hbahk/isoplane-back-illumination/preview-v09.png

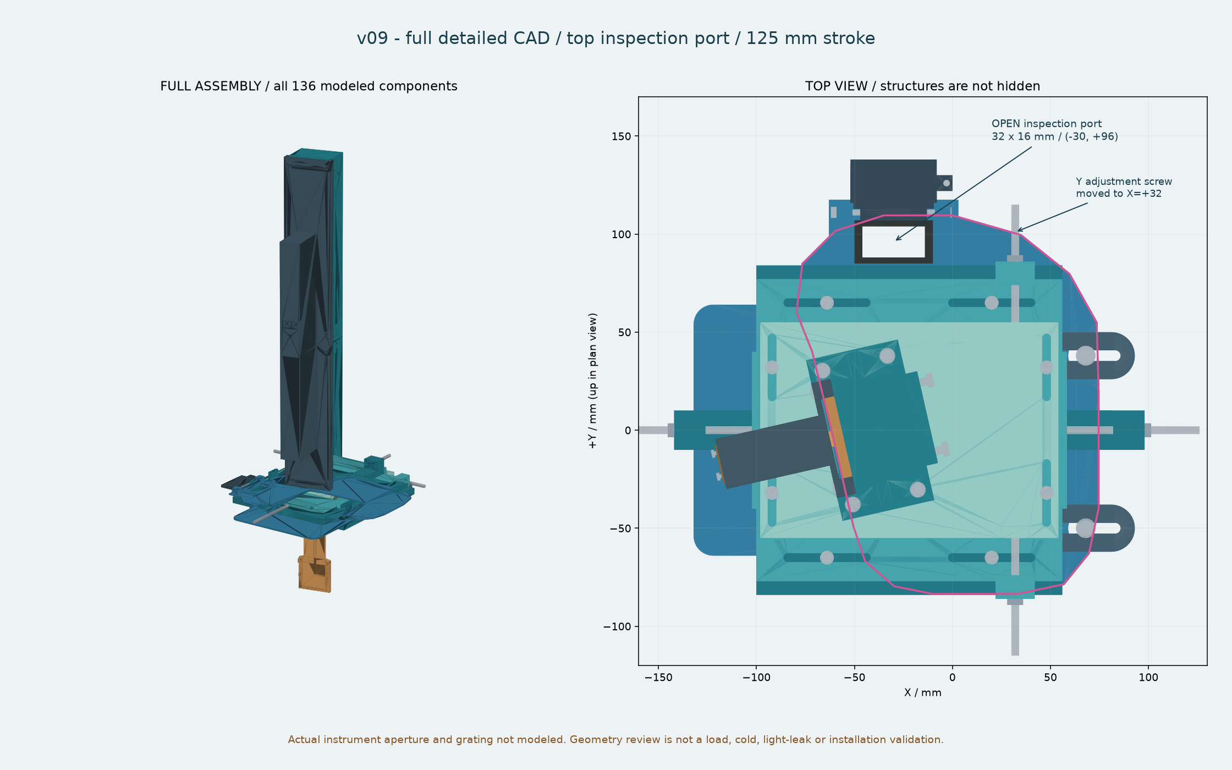
preview-v09.png
