hbahk/isoplane-back-illumination/preview.png

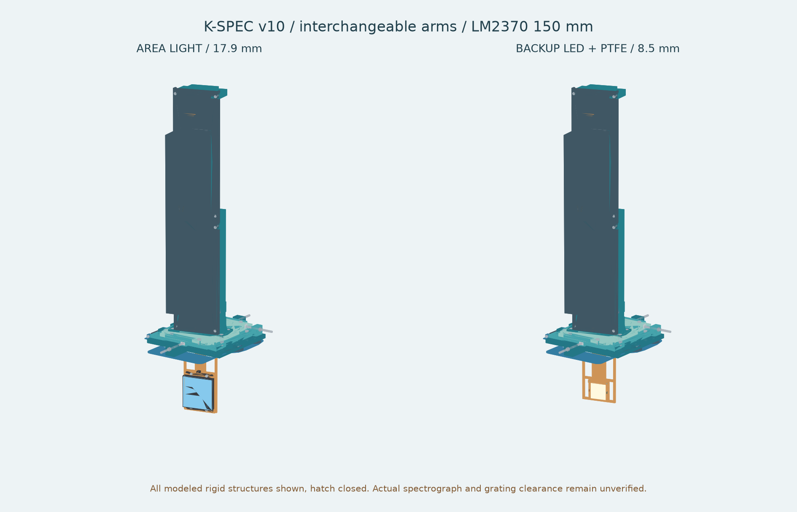
preview.png
