hbahk/isoplane-back-illumination/models/assembly_v17f_OUT.stl

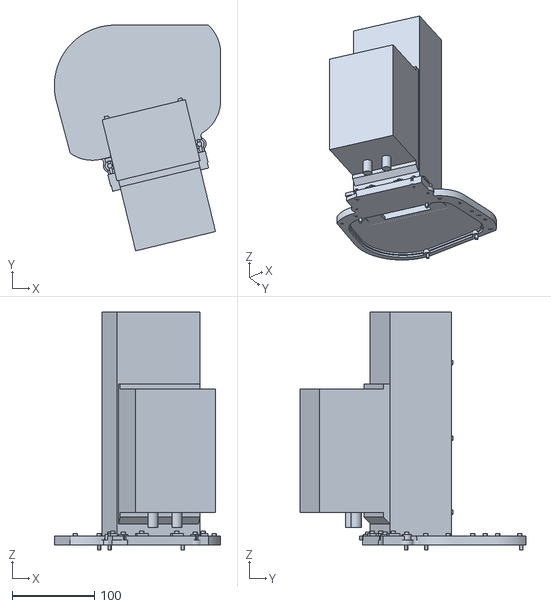
[picture p10: CAD file, 2026-11-11]
models/assembly_v17f_OUT.stl
202.2 x 274.5 x 289.4
