hbahk/isoplane-back-illumination/models/print/V17f_lid.stl

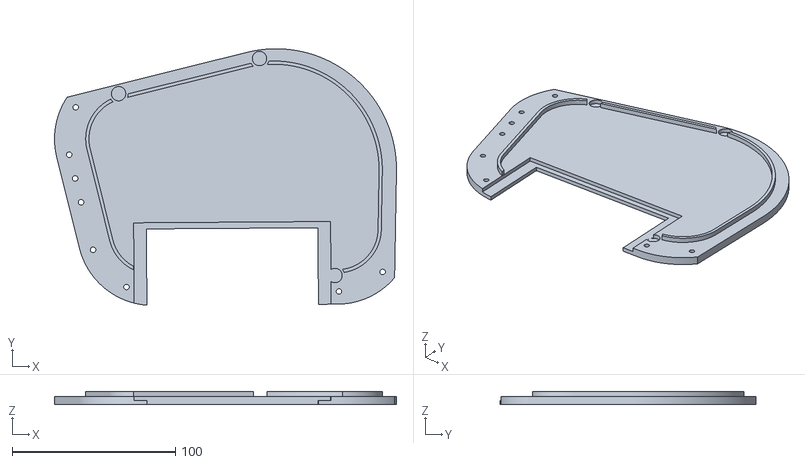
[picture p11: CAD file, 2026-11-11]
models/print/V17f_lid.stl
209.4 x 157.0 x 8.00
