hbahk/isoplane-back-illumination/models/print/V17f_tower_base.stl

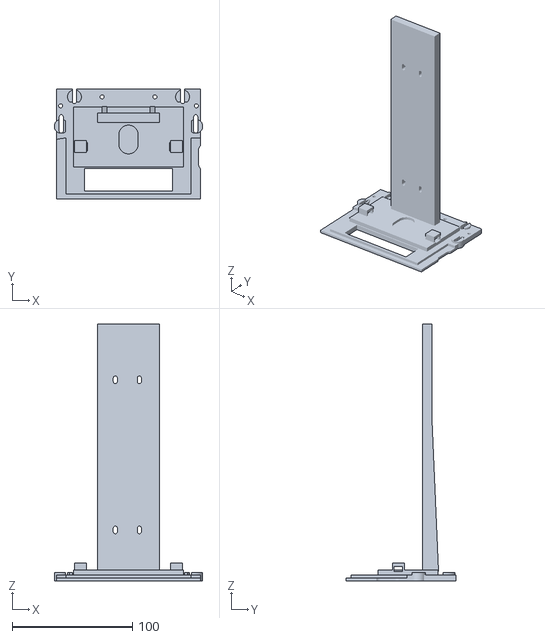
[picture p12: CAD file, 2026-11-11]
models/print/V17f_tower_base.stl
123.6 x 91.5 x 214.0
