hbahk/isoplane-back-illumination/models/print/coupon_B_front_boss.stl

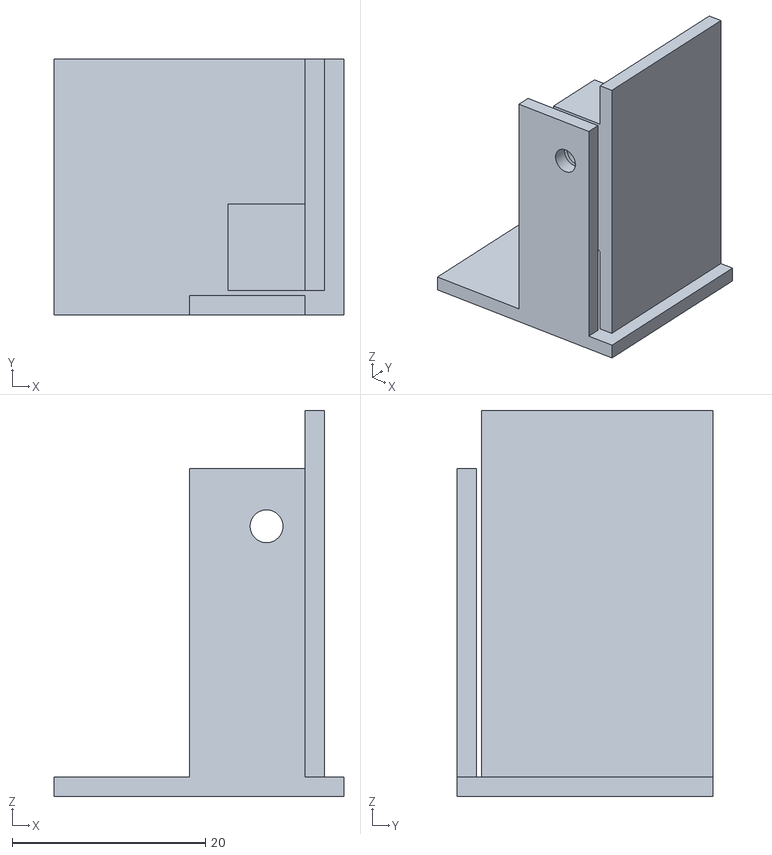
[picture p13: CAD file, 2026-11-11]
models/print/coupon_B_front_boss.stl
30.0 x 26.5 x 40.0
