hbahk/isoplane-back-illumination/models/print/V17f_front_panel.stl

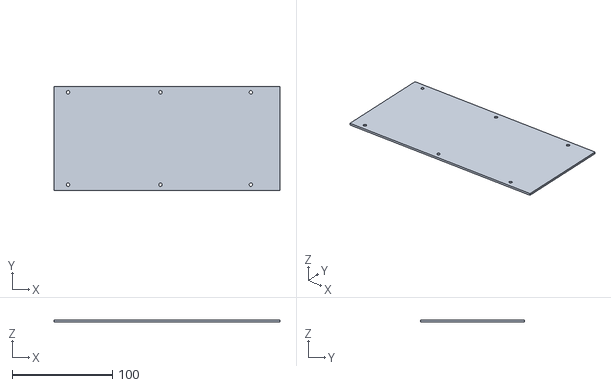
[picture p14: CAD file, 2026-11-11]
models/print/V17f_front_panel.stl
225.0 x 104.0 x 2.00
