hbahk/isoplane-back-illumination/models/print/V17f_ring_base.stl

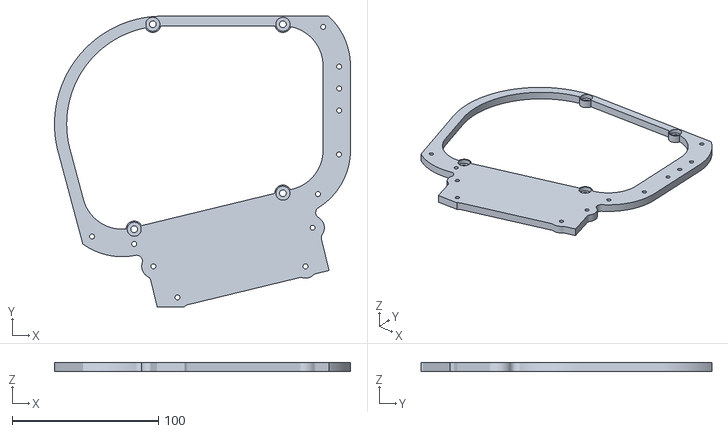
[picture p15: CAD file, 2026-11-11]
models/print/V17f_ring_base.stl
202.2 x 198.7 x 6.00
