hbahk/isoplane-back-illumination/models/print/V17f_enclosure.stl

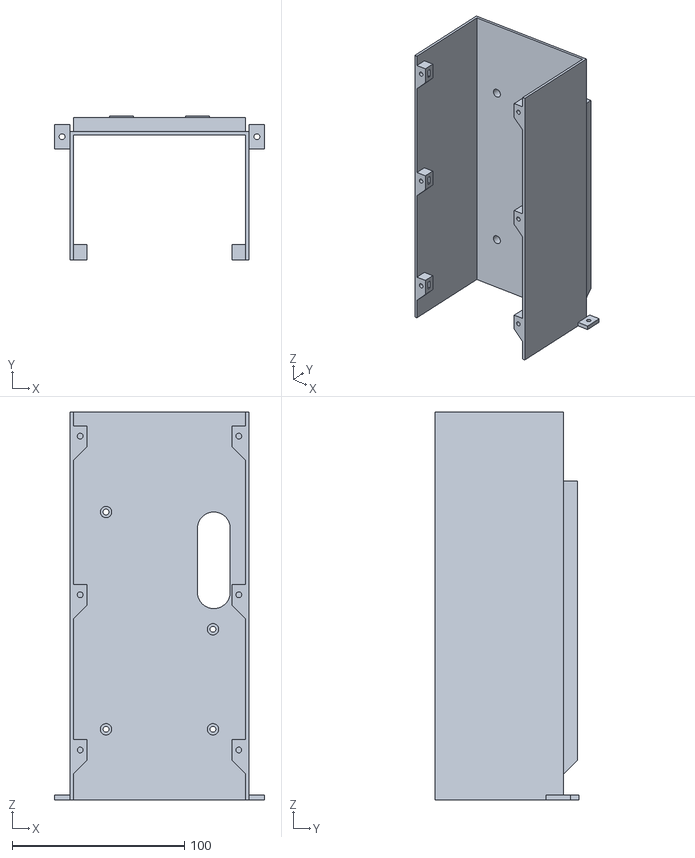
[picture p16: CAD file, 2026-11-11]
models/print/V17f_enclosure.stl
122.0 x 83.5 x 225.0
