hbahk/isoplane-back-illumination/models/print/V17f_backup_strip_module.stl

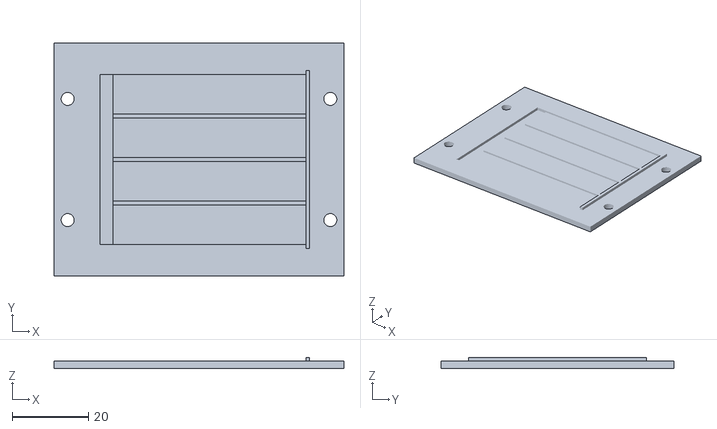
[picture p17: CAD file, 2026-11-11]
models/print/V17f_backup_strip_module.stl
76.0 x 61.0 x 3.00
