hbahk/isoplane-back-illumination/models/print/V17f_backup_led_module.stl

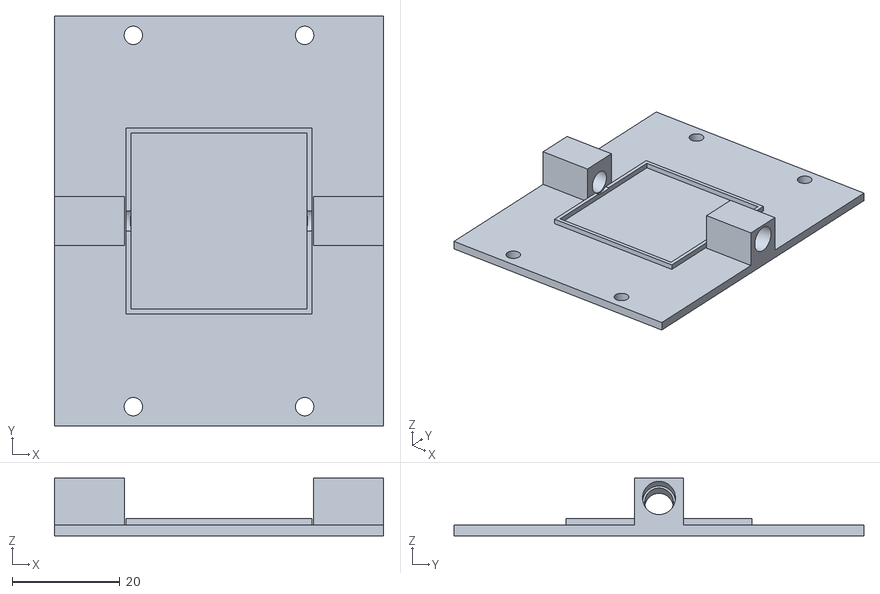
[picture p18: CAD file, 2026-11-11]
models/print/V17f_backup_led_module.stl
61.0 x 76.0 x 10.7
