hbahk/isoplane-back-illumination/models/print/V17f_top_cap.stl

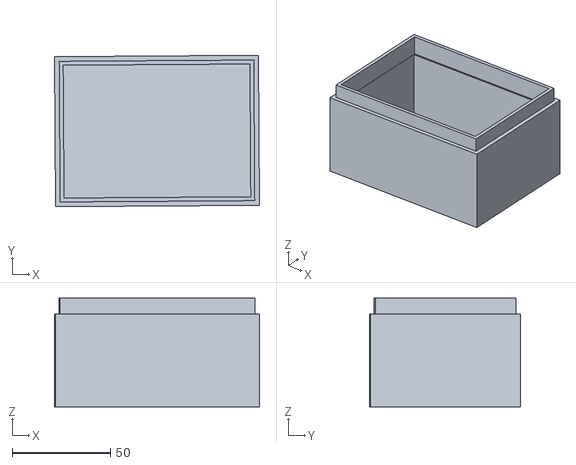
[picture p19: CAD file, 2026-11-11]
models/print/V17f_top_cap.stl
104.5 x 77.2 x 55.5
