hbahk/isoplane-back-illumination/models/print/V17f_light_carrier.stl

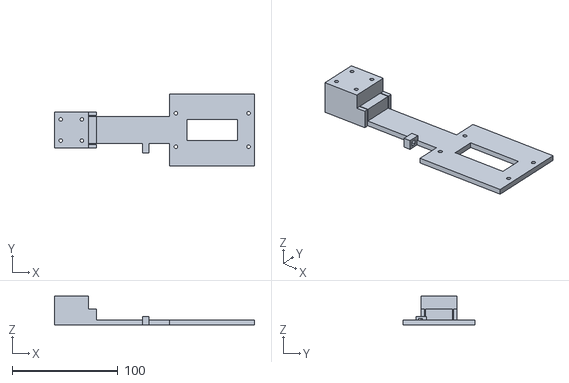
[picture p20: CAD file, 2026-11-11]
models/print/V17f_light_carrier.stl
189.4 x 68.0 x 27.0
