hbahk/isoplane-back-illumination/models/print/V17f_backup_reflector.stl

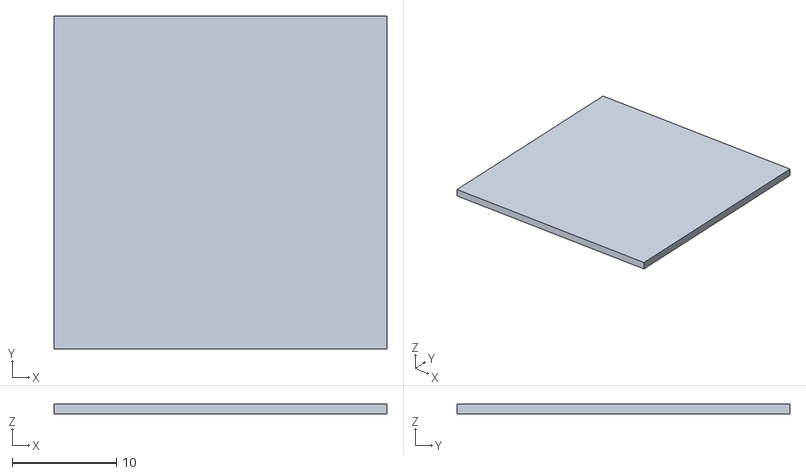
[picture p21: CAD file, 2026-11-11]
models/print/V17f_backup_reflector.stl
32.0 x 32.0 x 1.00
