hbahk/isoplane-back-illumination/models/print/coupon_A_nut_pockets.stl

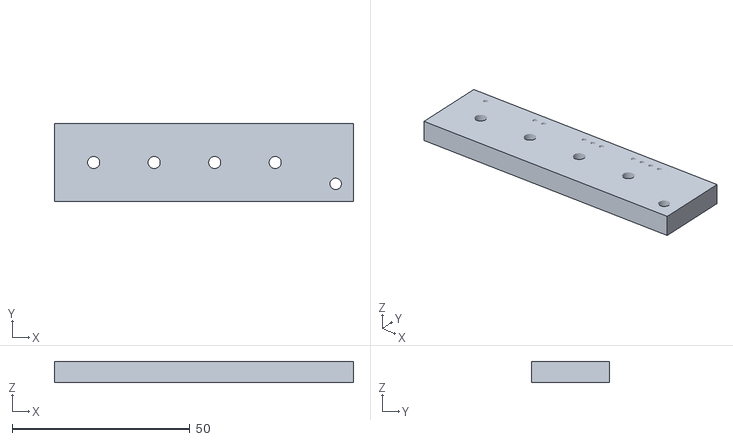
[picture p22: CAD file, 2026-11-11]
models/print/coupon_A_nut_pockets.stl
84.0 x 22.0 x 6.00
