hbahk/isoplane-back-illumination/(commit log)

2026-09-28 Publish v09 interactive design review
    [parts.csv]
2026-09-29 Publish v10 area-light and interchangeable LED backup models
    Add the supplied Metaphase area-light geometry, a 150 mm LM2370 layout, and an 8.5 mm PTFE/LED backup arm. Include separate wiring diagrams, print parts, and verification limits. Preserve v09 as an archived review. Instrument fit, grating clearance, structural strength, and fracture capture remain unverified.
    [additional-parts.csv, parts-v09.csv, parts.csv]
2026-11-11 Publish v17f as-built design: viewer, STLs, firmware, English README
    Final stage-based design (v17f) as installed on the IsoPlane SCT320.
    The viewer and STLs omit all spectrograph geometry. v09 and v10 move to archive/.
